particitae/DRIRMU/Images/Schéma-Electroniqe-Arduino.png

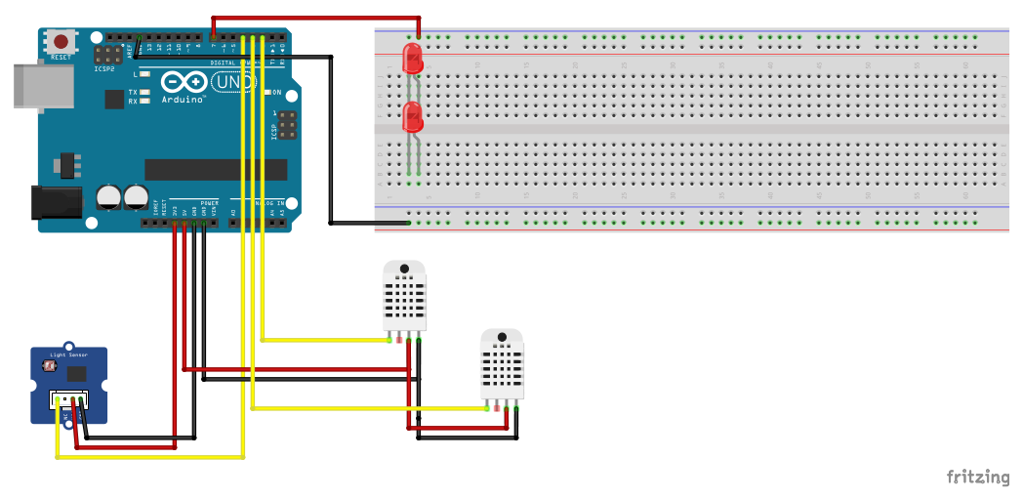
Images/Schéma-Electroniqe-Arduino.png
