particitae/DRIRMU/(commit log)

2019-02-05 Create Arduino
2019-02-17 modification de l'image Processus
